Kuhfeldrf/mackerel/files/curled_preview.png

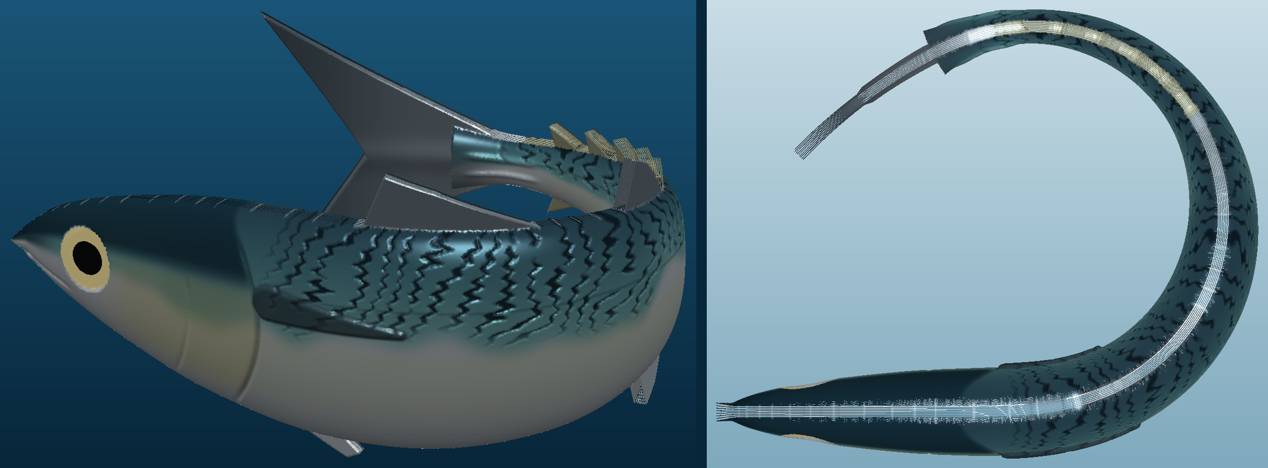
files/curled_preview.png
