Kuhfeldrf/mackerel/files/preview_finished_left_flank.png

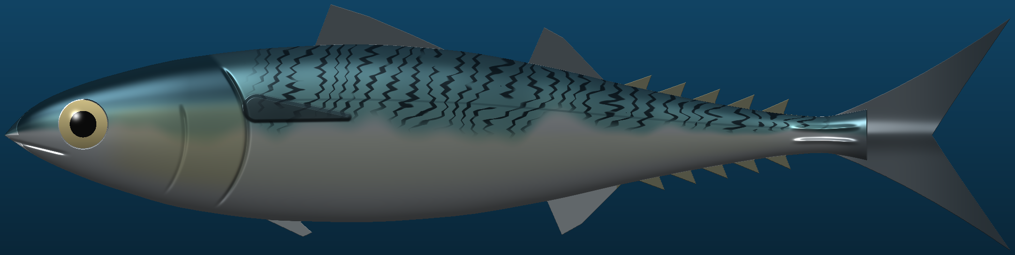
files/preview_finished_left_flank.png
