Kuhfeldrf/mackerel/files/onepiece/onepiece_preview.png

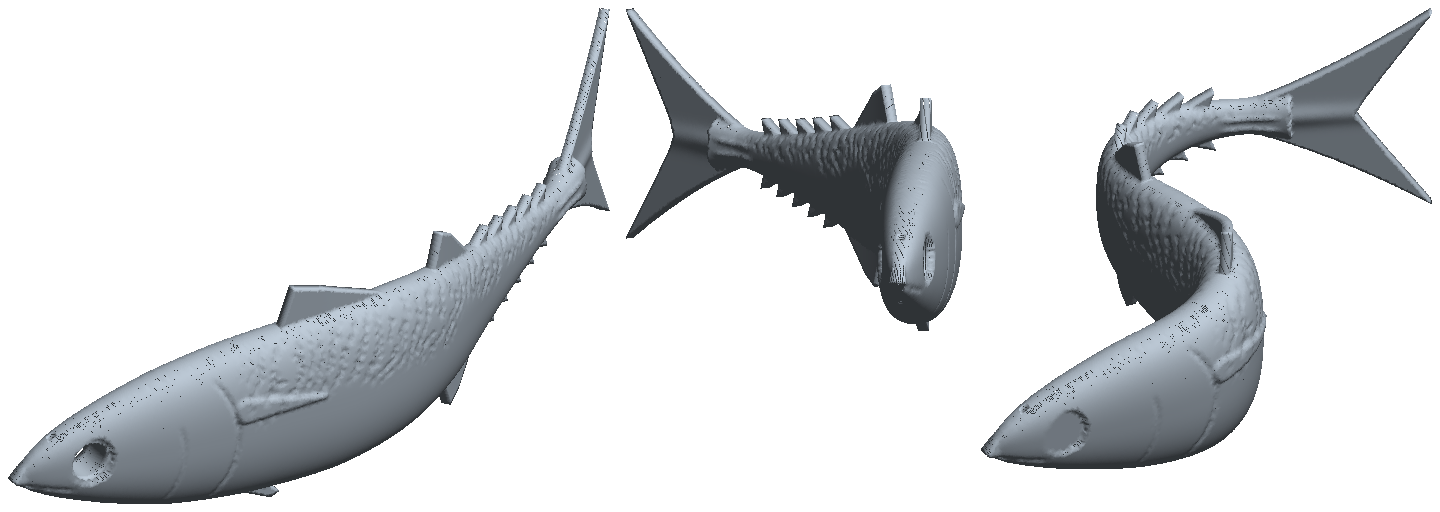
files/onepiece/onepiece_preview.png
