Kuhfeldrf/mackerel/files/onepiece/headdown_kick30_onepiece.stl

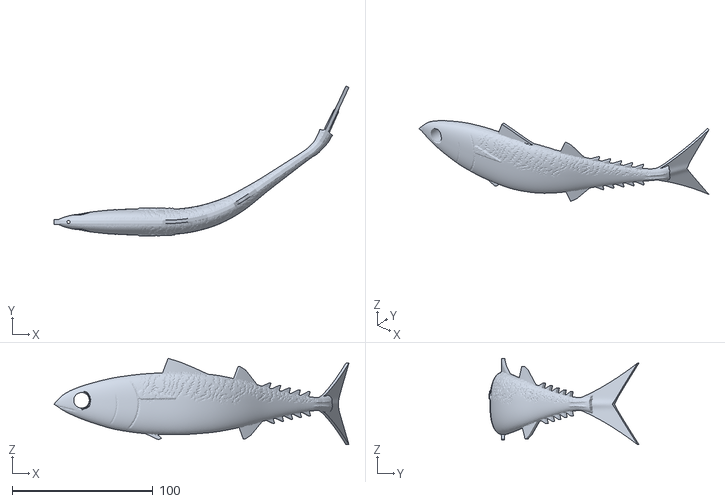
[picture p4: CAD file, 2026-10-26]
files/onepiece/headdown_kick30_onepiece.stl
209.3 x 106.5 x 61.3
