Kuhfeldrf/mackerel/files/wounded_mackerel_BELLY_half.stl

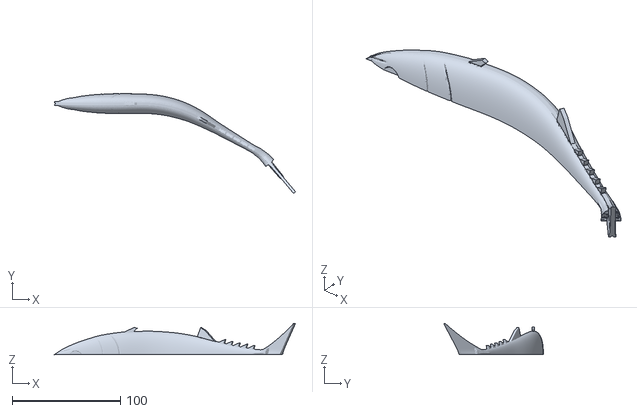
[picture p5: CAD file, 2026-10-26]
files/wounded_mackerel_BELLY_half.stl
223.1 x 92.3 x 28.7
