Kuhfeldrf/mackerel/files/onepiece/headdown_kick10_onepiece.stl

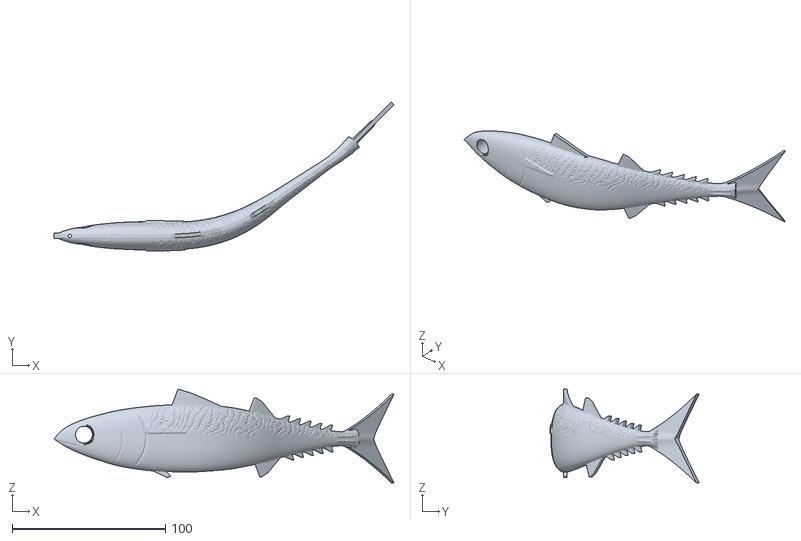
[picture p6: CAD file, 2026-10-26]
files/onepiece/headdown_kick10_onepiece.stl
221.9 x 97.4 x 61.3
