Kuhfeldrf/mackerel/files/wounded_kick30_mackerel_BACK_half.stl

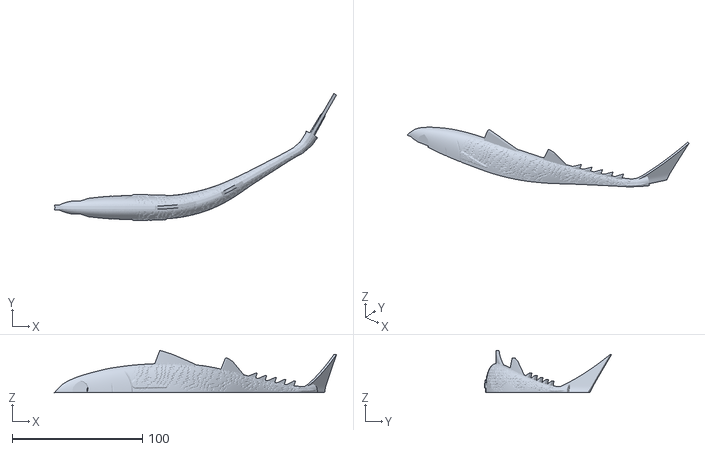
[picture p7: CAD file, 2026-10-26]
files/wounded_kick30_mackerel_BACK_half.stl
216.8 x 97.6 x 32.5
