Kuhfeldrf/mackerel/files/onepiece/straight_onepiece.stl

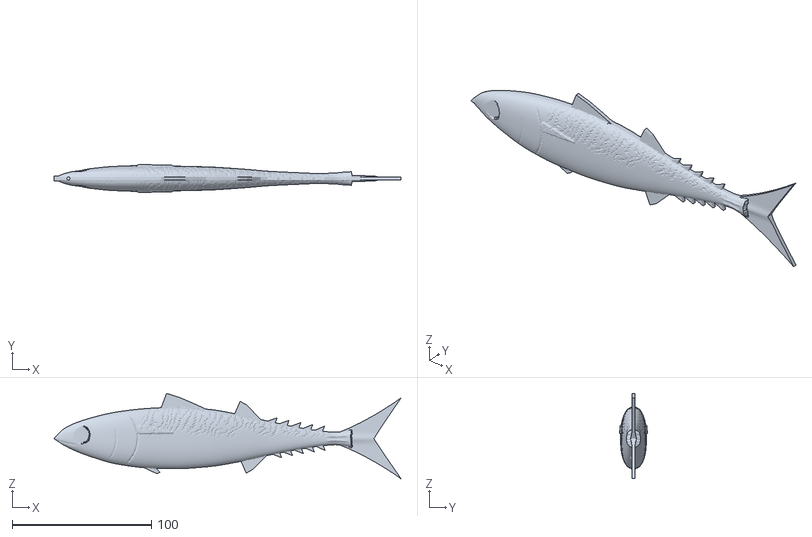
[picture p8: CAD file, 2026-10-26]
files/onepiece/straight_onepiece.stl
249.5 x 20.0 x 61.3
