Kuhfeldrf/mackerel/files/wounded_mackerel_BACK_half.stl

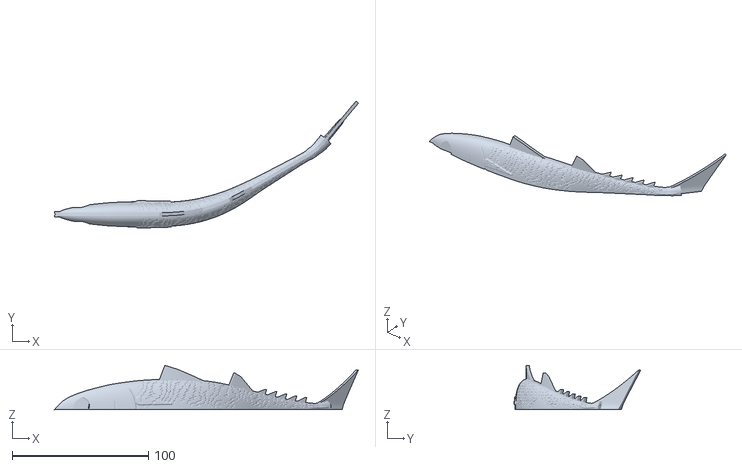
[picture p9: CAD file, 2026-10-26]
files/wounded_mackerel_BACK_half.stl
223.1 x 93.0 x 32.5
