Kuhfeldrf/mackerel/files/onepiece/headdown_onepiece.stl

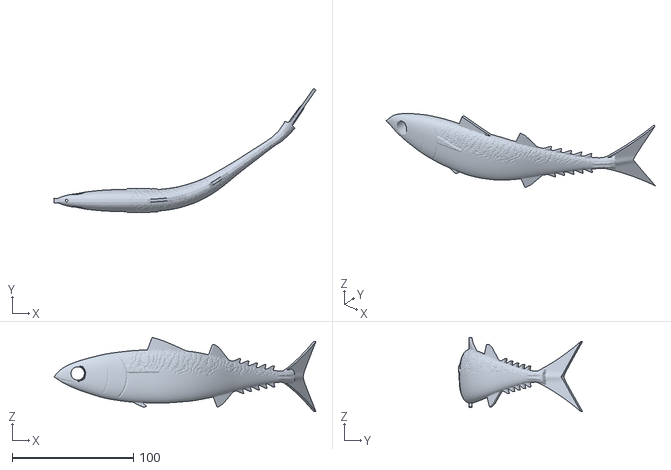
[picture p10: CAD file, 2026-10-26]
files/onepiece/headdown_onepiece.stl
216.0 x 102.5 x 61.3
