Kuhfeldrf/mackerel/files/wounded_kick30_mackerel_BELLY_half.stl

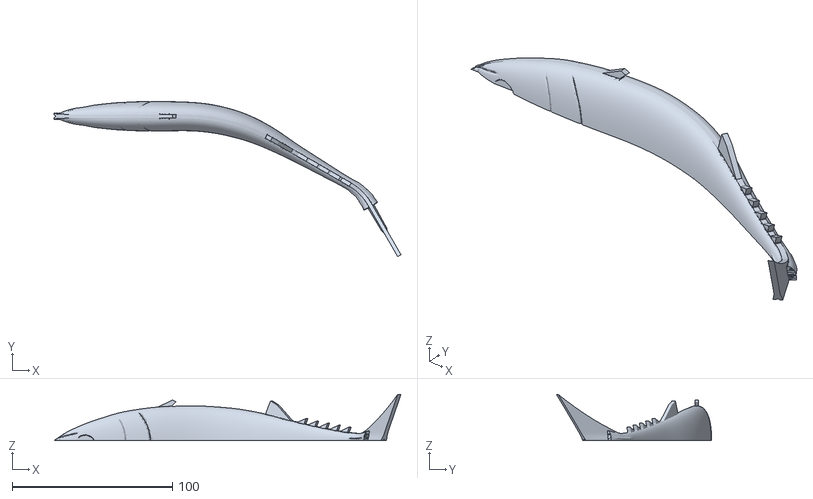
[picture p11: CAD file, 2026-10-26]
files/wounded_kick30_mackerel_BELLY_half.stl
216.8 x 96.9 x 28.7
