Kuhfeldrf/mackerel/files/onepiece/ucurl_onepiece.stl

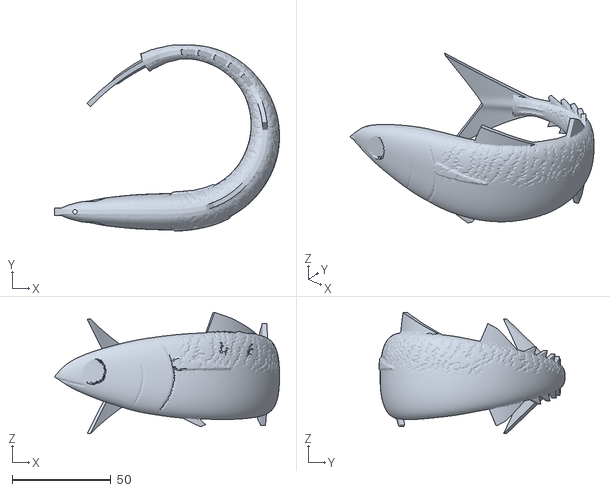
[picture p12: CAD file, 2026-10-26]
files/onepiece/ucurl_onepiece.stl
113.8 x 94.2 x 61.3
