Kuhfeldrf/mackerel/files/wounded_kick10_mackerel_BACK_half.stl

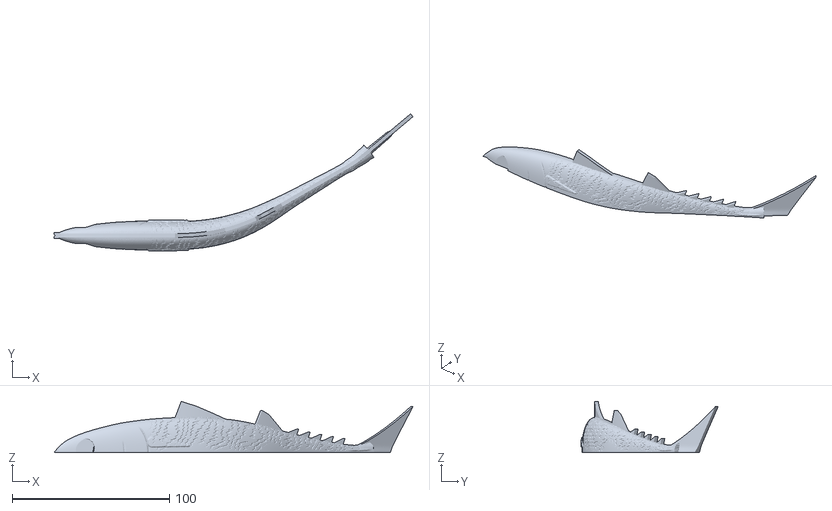
[picture p13: CAD file, 2026-10-26]
files/wounded_kick10_mackerel_BACK_half.stl
228.5 x 87.4 x 32.5
