Kuhfeldrf/mackerel/files/onepiece/scurve_onepiece.stl

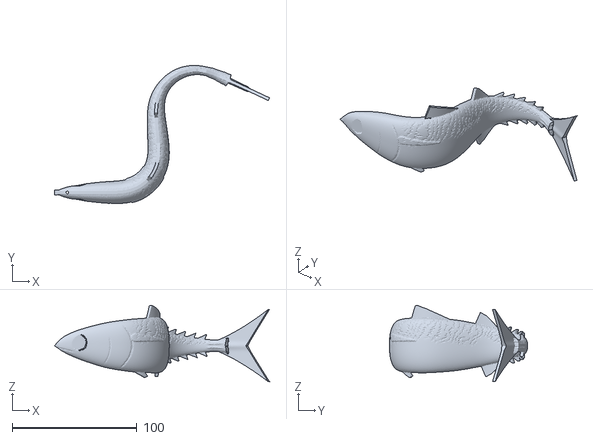
[picture p14: CAD file, 2026-10-26]
files/onepiece/scurve_onepiece.stl
172.6 x 110.8 x 61.3
