Kuhfeldrf/mackerel/files/wounded_kick10_mackerel_BELLY_half.stl

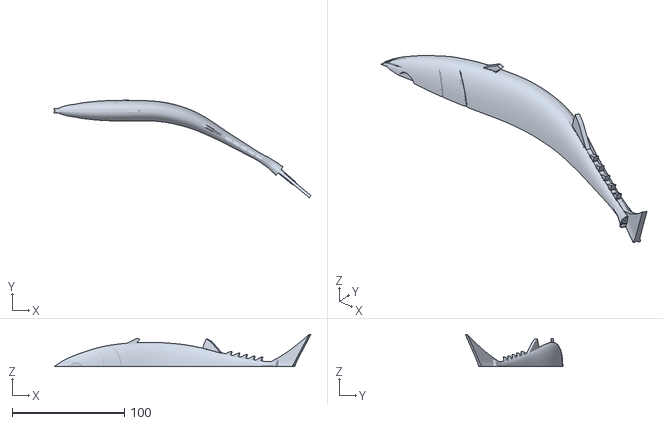
[picture p15: CAD file, 2026-10-26]
files/wounded_kick10_mackerel_BELLY_half.stl
228.5 x 86.7 x 28.7
