Kuhfeldrf/mackerel/files/scurve_mackerel_BELLY_half.stl

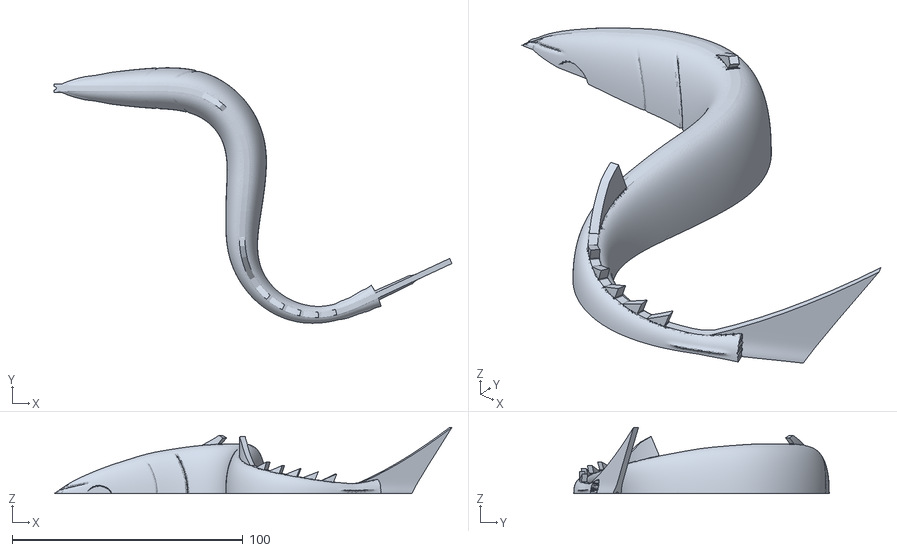
[picture p16: CAD file, 2026-10-26]
files/scurve_mackerel_BELLY_half.stl
172.6 x 110.8 x 28.7
