Kuhfeldrf/mackerel/files/scurve_mackerel_BACK_half.stl

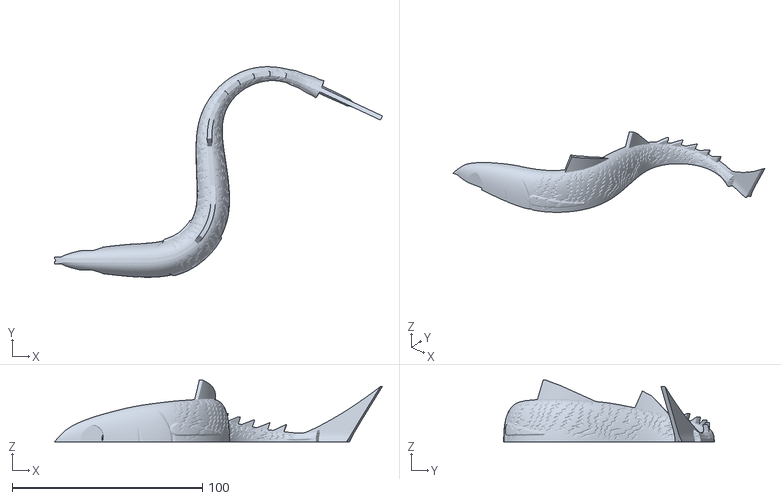
[picture p17: CAD file, 2026-10-26]
files/scurve_mackerel_BACK_half.stl
172.6 x 110.8 x 32.5
