Kuhfeldrf/mackerel/files/mackerel_flasher_LEFT_half.stl

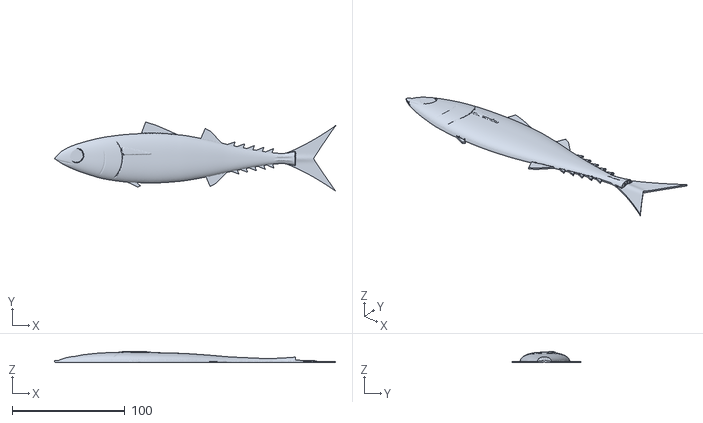
[picture p18: CAD file, 2026-10-26]
files/mackerel_flasher_LEFT_half.stl
249.5 x 61.3 x 9.98
