Kuhfeldrf/mackerel/files/curled_mackerel_VENTRAL_half.stl

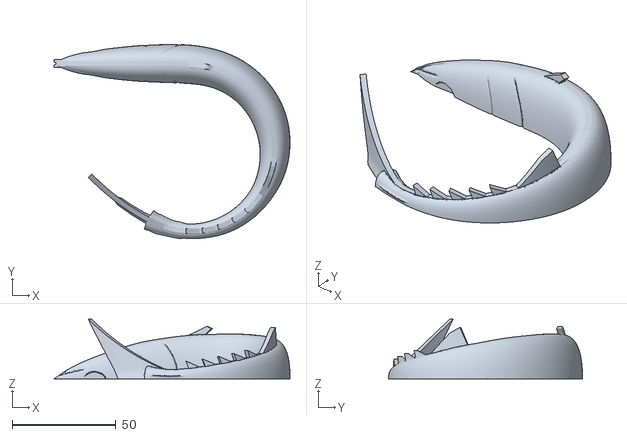
[picture p19: CAD file, 2026-10-26]
files/curled_mackerel_VENTRAL_half.stl
113.8 x 93.6 x 28.7
