Kuhfeldrf/mackerel/files/curled_mackerel_DORSAL_half.stl

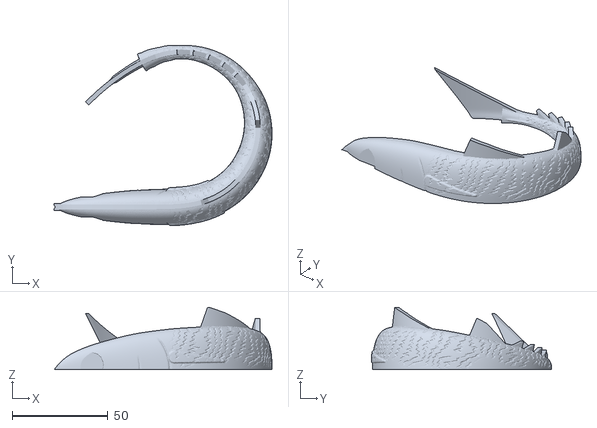
[picture p20: CAD file, 2026-10-26]
files/curled_mackerel_DORSAL_half.stl
113.8 x 94.2 x 32.5
