Kuhfeldrf/mackerel/(list of files, cad)

Other CAD files:
files/mackerel_flasher_RIGHT_half.stl
