Kuhfeldrf/mackerel/(commit log)

2026-10-26 Chub mackerel flasher 3D viewer and print files
    Claude-Session: https://claude.ai/code/session_01NWbVmXkD4KGQBPN4sidw3h
    [curled_mackerel_DORSAL_half.stl, curled_mackerel_VENTRAL_half.stl, mackerel_flasher_LEFT_half.stl, mackerel_flasher_RIGHT_half.stl]
2026-10-26 Add head-down slow-spiral design, sink simulation and curl video
    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
    [wounded_mackerel_BACK_half.stl, wounded_mackerel_BELLY_half.stl]
2026-10-26 Add S-curve print halves and README section
    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
    [scurve_mackerel_BACK_half.stl, scurve_mackerel_BELLY_half.stl]
2026-10-26 Add head-down sink video, steadier sink-test camera
    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
2026-10-26 Source: add calibrated strip-model simulator, plate validation and robustness tools
    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
2026-10-26 Head-down design: 30° bend + 20° kick, 12 g head charge; tail-kick tuning kit; README strategy from calibrated model
    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
    [wounded_kick10_mackerel_BACK_half.stl, wounded_kick10_mackerel_BELLY_half.stl, wounded_kick30_mackerel_BACK_half.stl, wounded_kick30_mackerel_BELLY_half.stl, wounded_mackerel_BACK_half.stl, wounded_mackerel_BELLY_half.stl]
2026-10-26 Viewer on calibrated strip model; robustness results; README numbers
    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
2026-10-26 One-piece PLA prints for OSU library (<5 MB each), head-down with sealed air + eye lead bore; new head-down video; README print guide
    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
    [headdown_kick0_onepiece.stl, headdown_kick20_onepiece.stl, headdown_onepiece.stl, scurve_onepiece.stl, straight_onepiece.stl, ucurl_onepiece.stl]
2026-10-26 Viewer: one-piece PLA designs with x-ray of line, lead, sealed air and balance points; 11 mm lead bore
    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
    [headdown_kick0_onepiece.stl, headdown_kick20_onepiece.stl, headdown_onepiece.stl, scurve_onepiece.stl, straight_onepiece.stl, ucurl_onepiece.stl]
2026-10-26 Head-down one-piece tuned for ~0.3 m/s: 20° tail kick, trim-to-5 g procedure, kick10/kick30 tuning files
    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
    [headdown_kick0_onepiece.stl, headdown_kick10_onepiece.stl, headdown_kick20_onepiece.stl, headdown_kick30_onepiece.stl, headdown_onepiece.stl]
